halumme/Swimmer_Power/(commit log)

2022-02-01 Add files via upload
    Arduino sketch for power cell readings
2022-02-01 Add files via upload
    Original script with English translation of comments and variable names. Bound to contain some errors.
    Otherwise embarrassingly clumsy code but still worked as intended
    [powercell_final.py]
2022-02-02 Add files via upload
    A short description of the design and use of the power cell device
2022-02-06 Add files via upload
    This small sketch is needed to facilitate the Python code testing. It outputs simulated scale data, which the Python script will plot.
    Made for Arduino MCU (Nano)
2022-02-06 Update powercell_final.py
    During a series of testing runs, several errors were reported. The corrections are implemented in this commit
    [powercell_final.py]
